UNL-Lunabotics/2026-tibble-bot/ros2/description/meshes/TLA.STL

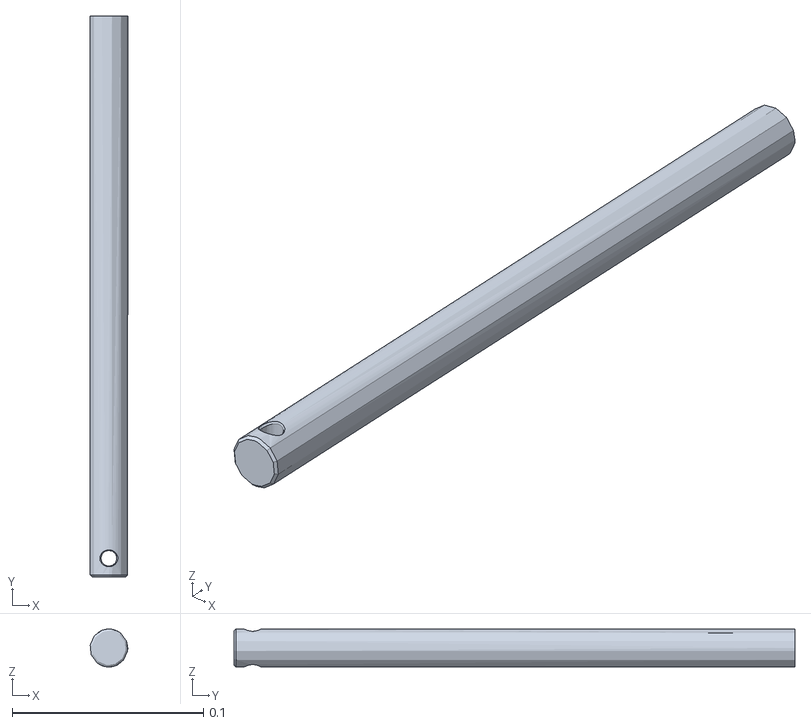
[picture p1: CAD file, 2026-03-10]
ros2/description/meshes/TLA.STL
0.0197 x 0.293 x 0.0199
