UNL-Lunabotics/2026-tibble-bot/ros2/description/meshes/TL_Wheel.STL

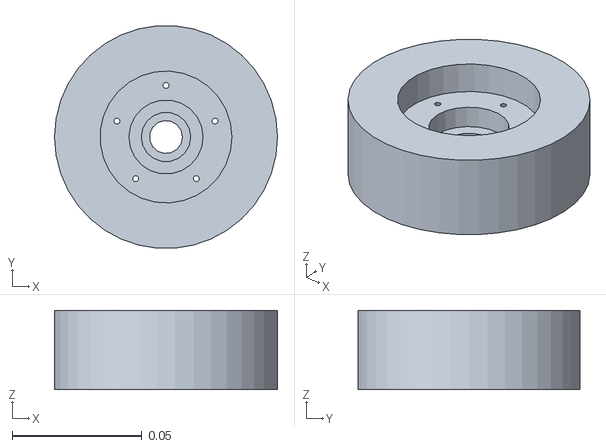
[picture p2: CAD file, 2026-03-10]
ros2/description/meshes/TL_Wheel.STL
0.0859 x 0.0856 x 0.0305
