UNL-Lunabotics/2026-tibble-bot/ros2/description/meshes/FR_Wheel.STL

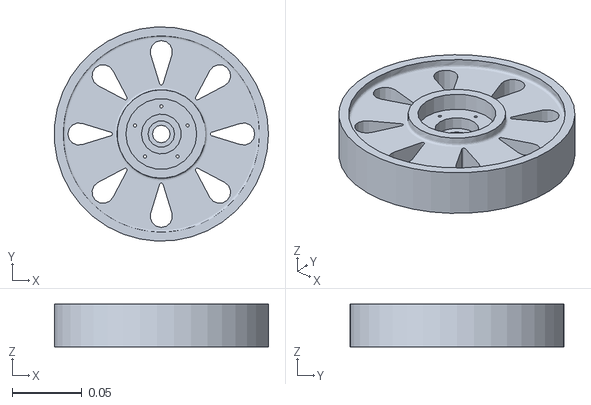
[picture p3: CAD file, 2026-03-10]
ros2/description/meshes/FR_Wheel.STL
0.153 x 0.154 x 0.0305
