UNL-Lunabotics/2026-tibble-bot/ros2/description/meshes/Excavation.STL

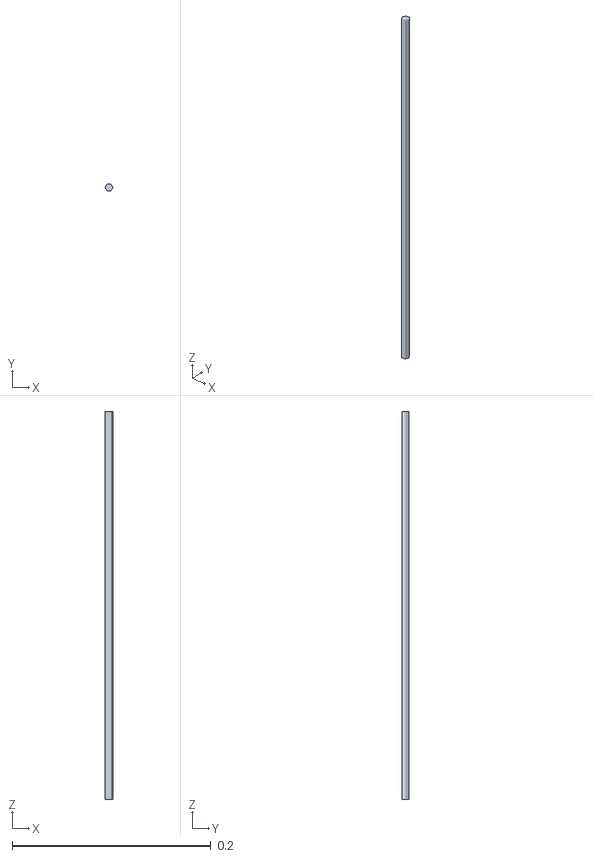
[picture p4: CAD file, 2026-03-10]
ros2/description/meshes/Excavation.STL
0.00808 x 0.007 x 0.39
