UNL-Lunabotics/2026-tibble-bot/ros2/description/meshes/Hopper_Door.STL

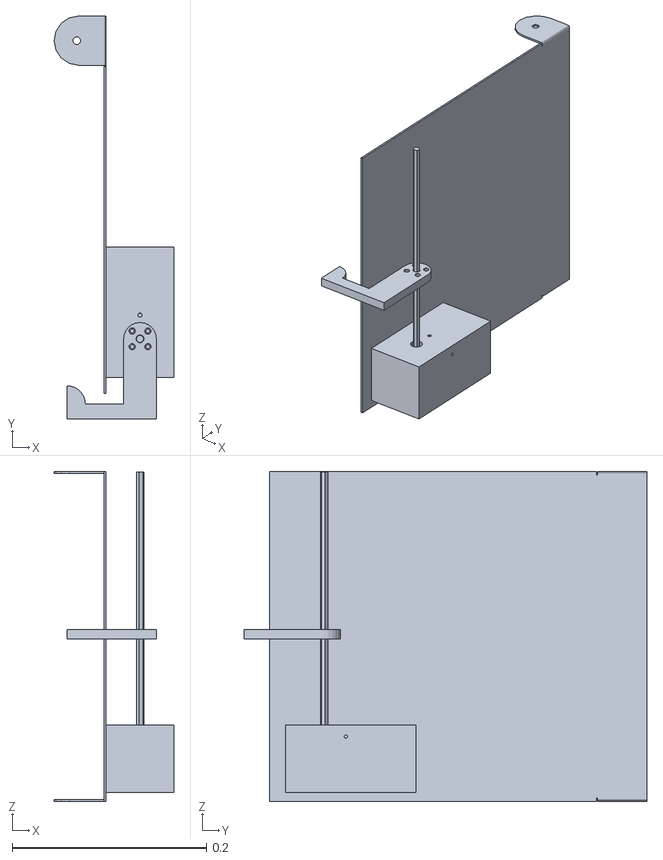
[picture p5: CAD file, 2026-03-10]
ros2/description/meshes/Hopper_Door.STL
0.123 x 0.415 x 0.34
