UNL-Lunabotics/2026-tibble-bot/ros2/description/meshes/Hopper.STL

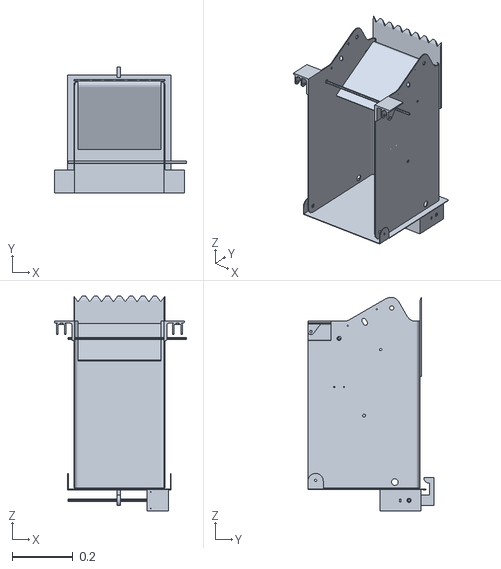
[picture p6: CAD file, 2026-03-10]
ros2/description/meshes/Hopper.STL
0.434 x 0.415 x 0.707
