UNL-Lunabotics/2026-tibble-bot/ros2/description/meshes/DL_Wheel.STL

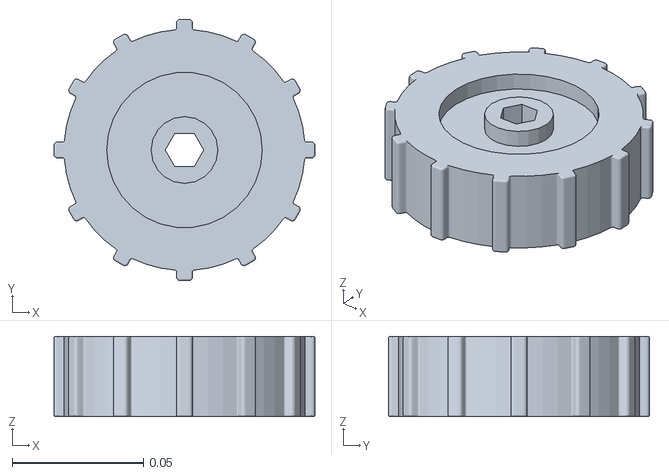
[picture p7: CAD file, 2026-03-10]
ros2/description/meshes/DL_Wheel.STL
0.0993 x 0.0993 x 0.0305
