UNL-Lunabotics/2026-tibble-bot/ros2/description/meshes/Hopper_Latch.STL

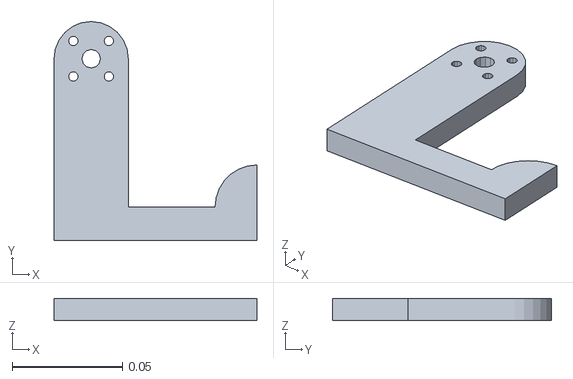
[picture p8: CAD file, 2026-03-10]
ros2/description/meshes/Hopper_Latch.STL
0.0922 x 0.0994 x 0.0102
