UNL-Lunabotics/2026-tibble-bot/ros2/description/meshes/BLA.STL

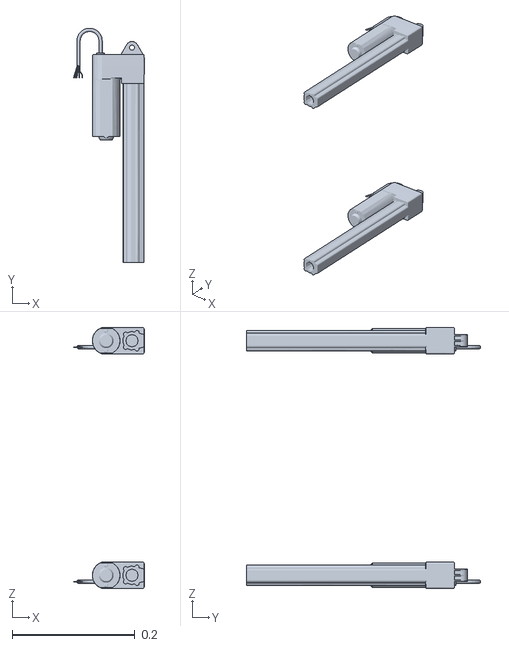
[picture p9: CAD file, 2026-03-07]
ros2/description/meshes/BLA.STL
0.115 x 0.382 x 0.425
