UNL-Lunabotics/2026-tibble-bot/ros2/description/meshes/base_link.STL

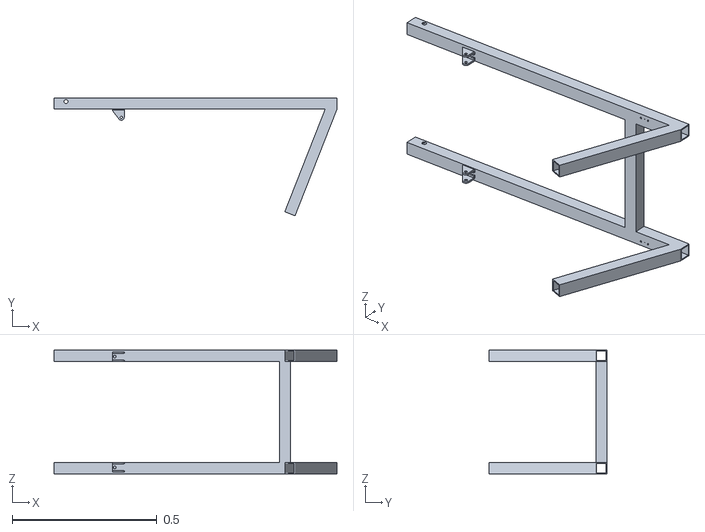
[picture p10: CAD file, 2026-03-07]
ros2/description/meshes/base_link.STL
0.976 x 0.406 x 0.426
