UNL-Lunabotics/2026-tibble-bot/(list of files, cad)

Other CAD files:
ros2/description/meshes/MR_Wheel.STL
ros2/description/meshes/TR_Wheel.STL
ros2/description/meshes/LA.STL
ros2/description/meshes/ML_Wheel.STL
ros2/description/meshes/BL_Wheel.STL
ros2/description/meshes/FL_Wheel.STL
ros2/description/meshes/DR_Wheel.STL
ros2/description/meshes/BR_Wheel.STL
