UNL-Lunabotics/2026-tibble-bot/ros2/control/src/tibble_controller.cpp

#include "control/tibble_controller.hpp"

#include <algorithm>
#include <optional>

#include <pluginlib/class_list_macros.hpp>
#include "hardware_interface/types/hardware_interface_type_values.hpp"

namespace tibble_controller
{
    controller_interface::InterfaceConfiguration TibbleController::command_interface_configuration() const
    {
        controller_interface::InterfaceConfiguration config;
        config.type = controller_interface::interface_configuration_type::INDIVIDUAL;
        config.names = { // order in here determines array index order
            left_wheel_name_ + "/velocity",
            right_wheel_name_ + "/velocity",
            linear_actuator_name_ + "/position",
            excavation_name_ + "/velocity",
            vibe_gpio_name_ + "/vibe_enabled",
            latch_gpio_name_ + "/hop_latched",
            linear_actuator_name_ + "/la_reset"
        };

        return config;
    }

    controller_interface::InterfaceConfiguration TibbleController::state_interface_configuration() const
    {
        controller_interface::InterfaceConfiguration config;
        config.type = controller_interface::interface_configuration_type::INDIVIDUAL;

        config.names = {
            left_wheel_name_ + "/velocity",
            left_wheel_name_ + "/position",
            right_wheel_name_ + "/velocity",
            right_wheel_name_ + "/position",
            linear_actuator_name_ + "/position"
        };

        return config;
    }

    controller_interface::CallbackReturn TibbleController::on_init()
    {
        try
        {
            // Receive params from tibble_controller.yaml
            auto_declare<double>("wheel_radius_m", 0.0);
            auto_declare<double>("wheel_separation_m", 0.0);
            auto_declare<double>("paddle_speed", 0.0);
            auto_declare<double>("manual_paddle_max_speed", 0.0);
            auto_declare<double>("manual_la_speed", 0.0);
        }
        catch(const std::exception& e)
        {
            RCLCPP_ERROR(get_node()->get_logger(), "on_init exception: %s", e.what());
            return controller_interface::CallbackReturn::ERROR;
        }
        return controller_interface::CallbackReturn::SUCCESS;
    }

    controller_interface::CallbackReturn TibbleController::on_configure(const rclcpp_lifecycle::State &)
    {
        // Set local variables to the node parameter values
        wheel_radius_ = get_node()->get_parameter("wheel_radius_m").as_double();
        wheel_separation_ = get_node()->get_parameter("wheel_separation_m").as_double();
        paddle_speed_ = get_node()->get_parameter("paddle_speed").as_double();
        manual_paddle_max_speed_ = get_node()->get_parameter("manual_paddle_max_speed").as_double();
        manual_la_speed_ = get_node()->get_parameter("manual_la_speed").as_double();

        // ROS subscriptions
        cmd_vel_sub_ = get_node()->create_subscription<geometry_msgs::msg::Twist>(
            "/cmd_vel", rclcpp::SystemDefaultsQoS(),
            [this](const geometry_msgs::msg::Twist::SharedPtr msg) {
                twist_cmd_buffer_.writeFromNonRT(*msg);
            });
        
        joy_sub_ = get_node()->create_subscription<sensor_msgs::msg::Joy>(
            "/joy", rclcpp::SystemDefaultsQoS(),
            [this](const sensor_msgs::msg::Joy::SharedPtr msg) {
                joy_cmd_buffer_.writeFromNonRT(*msg);
            });
        
        // ROS publishers
        odom_pub_ = get_node()->create_publisher<nav_msgs::msg::Odometry>("/odom", rclcpp::SystemDefaultsQoS());
        tf_broadcaster_ = std::make_shared<tf2_ros::TransformBroadcaster>(*get_node());

        // Create the service server for set state
        state_service_ = get_node()->create_service<interfaces::srv::SetTibbleState>(
            "~/set_state",
            std::bind(&TibbleController::set_state_callback, this, std::placeholders::_1, std::placeholders::_2)
        );

        RCLCPP_INFO(get_node()->get_logger(), "Configured TibbleController.");
        
        return controller_interface::CallbackReturn::SUCCESS;
    }

    controller_interface::CallbackReturn TibbleController::on_activate(const rclcpp_lifecycle::State &)
    {
        current_state_ = STATE_IDLE;
        manual_mode_ = false;

        twist_cmd_buffer_.reset();
        joy_cmd_buffer_.reset();

        // Odom reset
        odom_x_ = 0.0;
        odom_y_ = 0.0;
        odom_theta_ = 0.0;
        first_update_ = true;
        
        // Manual mode reset
        latch_state_ = true;
        vibe_state_ = false;
        prev_manual_toggle_b_ = false;
        prev_latch_toggle_b_ = false;
        prev_vibe_toggle_b_ = false;
        first_joy_update_ = true;
        prev_la_reset_b_ = false;

        odom_pub_->on_activate();

        if (command_interfaces_.empty() || state_interfaces_.empty()) {
            RCLCPP_ERROR(get_node()->get_logger(), "Missing controller interfaces.");
            return controller_interface::CallbackReturn::ERROR;
        }

        RCLCPP_INFO(get_node()->get_logger(), "Activated TibbleController.");
        return controller_interface::CallbackReturn::SUCCESS;
    }
   
    controller_interface::CallbackReturn TibbleController::on_deactivate(const rclcpp_lifecycle::State &)
    {
        current_state_ = STATE_IDLE;
        manual_mode_ = false;

        odom_pub_->on_deactivate();

        RCLCPP_INFO(get_node()->get_logger(), "Deactivated TibbleController.");
        return controller_interface::CallbackReturn::SUCCESS;
    }

    void TibbleController::set_state_callback(
        const std::shared_ptr<interfaces::srv::SetTibbleState::Request> request,
        std::shared_ptr<interfaces::srv::SetTibbleState::Response> response)
    {
        if (manual_mode_) {
            response->success = false;
            response->message = "Service rejected: Controller is currently in MANUAL mode.";
            return;
        }

        if (request->requested_state > STATE_DUMP) {
            response->success = false;
            response->message = "Invalid state requested.";
            return;
        }

        current_state_.store(request->requested_state);
        
        response->success = true;
        response->message = "State transitioned successfully.";
        
        RCLCPP_INFO(get_node()->get_logger(), "Service call received: Switched to state %d", request->requested_state);
    }

    controller_interface::return_type TibbleController::update(const rclcpp::Time & time, const rclcpp::Duration & period)
    {
        (void)time; // Silence unused param warning

        if (period.seconds() <= 0.0) {
            return controller_interface::return_type::OK;
        }

        // --- First, read inputs ---
        double current_left_pos = state_interfaces_[1].get_optional().value_or(0.0);
        double current_right_pos = state_interfaces_[3].get_optional().value_or(0.0);
        double current_la_pos = state_interfaces_[4].get_optional().value_or(0.0);

        // --- Second, odometry math ---
        if (first_update_) {
            last_left_wheel_pos_ = current_left_pos;
            last_right_wheel_pos_ = current_right_pos;
            manual_la_pos_ = current_la_pos; // Init manual position tracker
            first_update_ = false;
        }

        // Calculate how much the wheels moved in radians since last tick
        double delta_left = current_left_pos - last_left_wheel_pos_;
        double delta_right = current_right_pos - last_right_wheel_pos_;

        // Convert radians to linear distance (meters)
        double distance_left = delta_left * wheel_radius_;
        double distance_right = delta_right * wheel_radius_;

        // Calculate robot's translation and rotation
        double linear_distance = (distance_right + distance_left) / 2.0;
        double angular_distance = (distance_right - distance_left) / wheel_separation_;

        // Update global pose using Runge-Kutta 2nd order approximation
        odom_theta_ += angular_distance;
        odom_x_ += linear_distance * std::cos(odom_theta_ - angular_distance / 2.0);
        odom_y_ += linear_distance * std::sin(odom_theta_ - angular_distance / 2.0);

        // Save current positions for the next loop
        last_left_wheel_pos_ = current_left_pos;
        last_right_wheel_pos_ = current_right_pos;

        // Publish Odometry & TF (Helper struct for quaternion math)
        double half_yaw = odom_theta_ * 0.5;
        double q_z = std::sin(half_yaw);
        double q_w = std::cos(half_yaw);

        if (odom_pub_->get_subscription_count() > 0) {
            nav_msgs::msg::Odometry odom_msg;
            odom_msg.header.stamp = get_node()->get_clock()->now();
            odom_msg.header.frame_id = "odom";
            odom_msg.child_frame_id = "base_link";
            odom_msg.pose.pose.position.x = odom_x_;
            odom_msg.pose.pose.position.y = odom_y_;
            odom_msg.pose.pose.orientation.z = q_z;
            odom_msg.pose.pose.orientation.w = q_w;
            odom_msg.twist.twist.linear.x = linear_distance / period.seconds();
            odom_msg.twist.twist.angular.z = angular_distance / period.seconds();
            odom_pub_->publish(odom_msg);
        }

        geometry_msgs::msg::TransformStamped tf_msg;
        tf_msg.header.stamp = get_node()->get_clock()->now();
        tf_msg.header.frame_id = "odom";
        tf_msg.child_frame_id = "base_link";
        tf_msg.transform.translation.x = odom_x_;
        tf_msg.transform.translation.y = odom_y_;
        tf_msg.transform.rotation.z = q_z;
        tf_msg.transform.rotation.w = q_w;
        tf_broadcaster_->sendTransform(tf_msg);

        // --- Third, read commands and process mode toggle ---
        auto twist_msg = twist_cmd_buffer_.readFromRT();
        auto joy_msg = joy_cmd_buffer_.readFromRT();

        if (joy_msg && joy_msg->buttons.size() > (size_t)std::max({MANUAL_TOGGLE_B, MANUAL_VIBE_TOGGLE_B})) {
            
            // Check for mode toggle edge detection
            if (first_joy_update_) {
                prev_manual_toggle_b_ = (joy_msg->buttons[MANUAL_TOGGLE_B] == 1);
                prev_latch_toggle_b_ = (joy_msg->buttons[MANUAL_LATCH_TOGGLE_B] == 1);
                prev_vibe_toggle_b_ = (joy_msg->buttons[MANUAL_VIBE_TOGGLE_B] == 1);
                prev_la_reset_b_ = (joy_msg->buttons[MANUAL_LA_RESET_B] == 1);
                first_joy_update_ = false;
            } else {
                bool current_manual_toggle = (joy_msg->buttons[MANUAL_TOGGLE_B] == 1);
                if (current_manual_toggle && !prev_manual_toggle_b_) {
                    manual_mode_ = !manual_mode_;
                    
                    if (!manual_mode_) {
                        current_state_ = STATE_IDLE;
                    }
                }
                prev_manual_toggle_b_ = current_manual_toggle;
            }
        }

        // Initialize safe output defaults
        double target_v = 0.0;
        double target_w = 0.0;
        double cmd_left_wheel = 0.0;
        double cmd_right_wheel = 0.0;
        double cmd_la_pos = 0.0;
        double cmd_excav_vel = 0.0;
        double cmd_vibe = 0.0;     // 0.0 = off, 1.0 = on
        double cmd_latch = latch_state_ ? 1.0 : 0.0;
        double cmd_la_reset = 0.0;

        // Read drivetrain twist
        if (twist_msg) {
            target_v = twist_msg->linear.x;
            target_w = twist_msg->angular.z;
        }

        // --- Fourth, Mode Execution Logic ---
        if (manual_mode_) {
            // ==========================================
            // MANUAL MODE LOGIC
            // ==========================================
            if (joy_msg) {
                bool extending = (joy_msg->buttons[MANUAL_LA_EXTEND_B] == 1);
                bool retracting = (joy_msg->buttons[MANUAL_LA_RETRACT_B] == 1);

                // Linear Actuator (Pseudo-Velocity)
                if (extending) {
                    cmd_la_pos = 1.0;
                } else if (retracting) {
                    cmd_la_pos = -1.0;
                } else {
                    cmd_la_pos = current_la_pos;
                }
  
                // Excavation
                if (joy_msg->axes.size() > (size_t)MANUAL_EXCAV_AXIS) {
                    double excav_axis = joy_msg->axes[MANUAL_EXCAV_AXIS];
                    // Map 1.0 -> 0 and -1.0 to 1.0 * max speed
                    // When not pressed at all, it is at 1.0, and when fully pressed it is -1.0
                    cmd_excav_vel = (-(excav_axis - 1.0) / 2.0) * manual_paddle_max_speed_;
                }

                // Latch Toggle
                bool current_latch_btn = (joy_msg->buttons[MANUAL_LATCH_TOGGLE_B] == 1);
                if (current_latch_btn && !prev_latch_toggle_b_) {
                    latch_state_ = !latch_state_;
                }
                prev_latch_toggle_b_ = current_latch_btn;
                cmd_latch = latch_state_ ? 1.0 : 0.0;

                // Vibe Toggle
                bool current_vibe_btn = (joy_msg->buttons[MANUAL_VIBE_TOGGLE_B] == 1);
                if (current_vibe_btn && !prev_vibe_toggle_b_) {
                    vibe_state_ = !vibe_state_;
                }
                prev_vibe_toggle_b_ = current_vibe_btn;
                cmd_vibe = vibe_state_ ? 1.0 : 0.0;

                bool current_la_reset_btn = (joy_msg->buttons[MANUAL_LA_RESET_B] == 1);
                if (current_la_reset_btn && !prev_la_reset_b_) {
                    cmd_la_reset = 1.0;
                    RCLCPP_WARN(get_node()->get_logger(), "MANUAL OVERRIDE: Triggering Linear Actuator Encoder Reset!");
                }
                prev_la_reset_b_ = current_la_reset_btn;
            }

            // Differential Drive Math (No speed multipliers in manual)
            cmd_left_wheel = (target_v - target_w * wheel_separation_ / 2.0) / wheel_radius_;
            cmd_right_wheel = (target_v + target_w * wheel_separation_ / 2.0) / wheel_radius_;

        } else {
            // ==========================================
            // STATE MACHINE LOGIC
            // ==========================================
            uint8_t local_state = current_state_.load();

            // Timer management for sequential steps
            if (local_state != previous_state_) {
                state_timer_ = 0.0;
                previous_state_ = local_state;
            } else {
                state_timer_ += period.seconds();
            }

            double speed_multiplier = 1.0;

            switch (local_state) {
                case STATE_IDLE:
                    // Safe defaults are already set above
                    break;

                case STATE_TRAVEL:
                    // Drivetrain runs, default positions hold
                    break;

                case STATE_EXCAVATE:
                    target_v = 0.2;
                    target_w = 0.0;
                    speed_multiplier = 1.0;

                    cmd_vibe = 1.0;
                    
                    cmd_la_pos = -1.0; // retract LA's forever
                    
                    cmd_excav_vel = paddle_speed_;
                    break;

                case STATE_DUMP:
                    speed_multiplier = 0.3; // Slow down drivetrain
                    
                    latch_state_ = false;
                    cmd_latch = 0.0; // Unlatch immediately

                    if (state_timer_ > DUMP_LA_DELAY && state_timer_ < (DUMP_LA_DELAY + EXCAVATE_EXTEND_TIME)) {
                        cmd_la_pos = 1.0; // Extend LA
                    } else if (state_timer_ >= (DUMP_LA_DELAY + EXCAVATE_EXTEND_TIME)) {
                        cmd_la_pos = 0.0; // Stop LA
                    }

                    if (state_timer_ > DUMP_VIBE_DELAY) {
                        cmd_vibe = 1.0;
                    }
                    break;
            }

            // Differential Drive Math (applied for TRAVEL, EXCAVATE, and DUMP)
            if (local_state != STATE_IDLE) {
                target_v *= speed_multiplier;
                target_w *= speed_multiplier;

                cmd_left_wheel = (target_v - target_w * wheel_separation_ / 2.0) / wheel_radius_;
                cmd_right_wheel = (target_v + target_w * wheel_separation_ / 2.0) / wheel_radius_;
            }
        }

        // no matter what, clamp to LA max (no min enforced)
        // cmd_la_pos = std::min(cmd_la_pos, LA_DUMP_POS);

        // --- Fifth, write commands ---
        
        // Order is declaration order in command_interface_configuration()
        (void)command_interfaces_[0].set_value(cmd_left_wheel);
        (void)command_interfaces_[1].set_value(cmd_right_wheel);
        (void)command_interfaces_[2].set_value(cmd_la_pos);
        (void)command_interfaces_[3].set_value(cmd_excav_vel);
        (void)command_interfaces_[4].set_value(cmd_vibe);
        (void)command_interfaces_[5].set_value(cmd_latch);
        (void)command_interfaces_[6].set_value(cmd_la_reset);

        RCLCPP_INFO_THROTTLE(get_node()->get_logger(), *get_node()->get_clock(), 3000,
            "MODE: %s | LA Cmd: %.4f | Vibe: %.0f | Latch: %.0f | Paddle: %.2f",
            manual_mode_ ? "MANUAL" : "STATE MACHINE",
            cmd_la_pos, cmd_vibe, cmd_latch, cmd_excav_vel);

        return controller_interface::return_type::OK;
    }

} // namespace tibble_controller


PLUGINLIB_EXPORT_CLASS(tibble_controller::TibbleController,
                       controller_interface::ControllerInterface)
