UNL-Lunabotics/2026-tibble-bot/(commit log)

2026-03-06 set all the ros2 packages up and ported over docker and teensy firmware from terrence 3
2026-03-07 control starting stuff from terrence
    [controllers.yaml]
2026-03-07 updated readme with state machine and motor info
2026-03-07 added basic urdf in and got a view urdf launcher working
    [Excavation_Link.STL, HopperDoor_Link.STL, Hopper_Link.STL, Hopperlatch_Link.STL, LAExtend_Link.STL, LA_Link.STL, LKraken_Link.STL, RKraken_Link.STL]
2026-03-07 added urdf migration notes to readme
2026-03-08 rewrote the teensy firmware to handle tibbs architecture
2026-03-10 added in tibbs urdf and meshes
    [BLA.STL, BL_Wheel.STL, BR_Wheel.STL, DL_Wheel.STL, DR_Wheel.STL, Excavation.STL, Excavation_Link.STL, FL_Wheel.STL]
2026-03-10 renamed chassis stl. transforms to base link complaining
    [tibble.urdf.xacro]
2026-03-12 urdf of tibbs renders in rviz properly
    [tibble.urdf.xacro]
2026-03-21 fixed the joint issues
    [tibble.urdf.xacro]
2026-03-21 split into proper urdf structure
    [gazebo.xacro, ros2_control.xacro, sensors.xacro, tibble.urdf.xacro, tibble_core.xacro]
2026-03-21 added missing name for robot
    [tibble.urdf.xacro]
2026-03-21 renamed controllers to tiblle_controller for clarity
    [tibble_controller.yaml]
2026-03-21 forgot to commit delete old controllers.yaml
    [controllers.yaml]
2026-03-21 changed robot name in urdf to uppercase Tibble
    [tibble.urdf.xacro]
2026-03-21 gave all the revolute and prismatic joints proper ranges so they show up (not mathematically correct)
    [tibble_core.xacro]
2026-03-21 defined joints and interfaces for ros2 control (not sim)
    [ros2_control.xacro]
2026-03-21 initial prototype controller (just writing, no reading encoders yet)
    [ros2_control.xacro]
2026-03-21 added odometry logic and physical position checking in
    [ros2_control.xacro]
2026-03-21 theoretically the hardware component is done, arduino comms revised, need to make can comms
    [ros2_control.xacro]
2026-03-21 teensy firmware updated
2026-03-21 added in slop can comms file that will need to be changed once we get that working
    [can_comms.hpp, tibble_hwc.cpp, tibble_hwc.hpp]
2026-03-25 yaml updated
    [tibble_controller.yaml]
2026-03-25 set up the individual arduino test scripts
2026-03-25 replaced controller placeholders with real values
    [tibble_controller.yaml]
2026-03-25 replaced placeholder REST and DUMP pos for LAs with real values
    [tibble_controller.hpp]
2026-03-27 updated teensy files
2026-03-27 can_comms and cmake edited to include correct phoenix6 stuff
    [can_comms.hpp]
2026-03-27 added in correct button schema for ellas wireless 8bit controler
    [tibble_controller.hpp]
2026-03-27 moved test files and fixed controller file path
    [excav_test.cpp]
2026-03-27 fixed name of param
    [ros2_control.xacro]
2026-03-27 fixed some interface mismatches between hwc and urdf
    [ros2_control.xacro]
2026-03-27 fixed excav interfaces in controller
    [tibble_controller.cpp]
2026-03-27 fixed transform and calc mismatches in the controller
    [tibble_controller.cpp]
2026-03-28 updated to use wired 3d pro controller not bluetooth
2026-03-28 updated a number of small bugs here and there
    [ros2_control.xacro, tibble_controller.yaml]
2026-03-28 temporarily commented out the encoder readings just to see if thats the bottleneck
2026-03-28 switched to global joy and vel topics
2026-03-28 updated teensy firmware
2026-03-28 fixed using undeclared var in firmware
    [main.cpp]
2026-03-28 added received commands indicator to teensy leds
2026-03-28 removed conditional breaking encoder feedback
2026-03-28 removed all la encoder reset logic
    [ros2_control.xacro]
2026-03-28 removed read encoder values reference to excav encoders
2026-03-28 Revert "removed all la encoder reset logic"
    This reverts commit d4a57ae18a7980f2c8775c0c08da8bf0d5364fba.
    [ros2_control.xacro]
2026-03-28 temp absurdly high tolerance for la out of sync
    [tibble_hwc.hpp]
2026-03-28 im so fucking tired man
2026-03-28 im still so tired
2026-04-04 added joystick support for teensy theoretically
2026-04-04 fixed odom to use lifecycle and be global
    [tibble_controller.cpp, tibble_controller.hpp]
2026-04-08 updated arduino test files
2026-04-09 fixed roboclaw issue AGAIN this is so annoying
    [manual_joystick.cpp]
2026-04-09 added led signal on teensy code
2026-04-09 added excac test back in but commented out drivetrain and LA movement
2026-04-09 other changes i forgot to stage :)
2026-04-09 made la encoder specific teensy test code
2026-04-09 made the la test code not terrible :)
2026-04-11 joystick control with simple python file + teensy script is working fully (on ellas computer with ellas 8bitdo controller)
2026-04-17 reworked how LA encoders work
    [main.cpp, manual_joystick.cpp, tibble_hwc.cpp]
2026-04-18 added in new urdf but it is identical to the old one
    [tibble_core_old.xacro]
2026-04-18 fixed issues with joystick yaml still being for 8bitdo and added stuff for manual mode
    [tibble_controller.yaml]
2026-04-18 added manual switch println
2026-04-18 added std:: before println
2026-04-18 added diagnostic debug print
2026-04-18 fixed it so the arduino comms is only looking for 2 encoders not 3 which was impossible
    [arduino_comms.hpp]
2026-04-18 allowing LA encoders to go negative
2026-04-18 swapped excav and vibe instructions (they were reversed on accident)
    [main.cpp]
2026-04-18 split teleop launch files into wireless mode
2026-04-18 handling the no button pressed state for LA manual mode
2026-04-18 fixed the logic oops
    [tibble_controller.cpp]
2026-04-18 added fix for excav spinning wrong way in hwc
    [main.cpp, tibble_hwc.cpp]
2026-04-18 switched hop servo from pin 7 to 9
2026-04-18 added velocity clamp to hopefully move the drivetrain
2026-04-18 added duty cycle ignoring pid
2026-04-18 making drivetrain and excavation faster
    [tibble_controller.yaml]
2026-04-23 initial prototype for cameras in wireless launch files
2026-04-24 i forgot to comment out the camera_rear object in launch description
2026-04-25 reversed excav direction and increased joystick
    [tibble_hwc.cpp]
2026-04-25 swopped hop servo values and it works now
2026-04-26 deleted obsolete teensy scripts
2026-04-26 renamed teensy_firmware to microcontroller_firmware
2026-04-26 added tibble bringup script that theoretically sets up onboard and groundstation console fully
2026-04-26 theoretically fixed the LA velocity vs simple on/off control problem
    [tibble_controller.cpp]
2026-04-26 added full stop commands during on_activate to prevent previous cmds from echoing to new runs
    [tibble_controller.cpp, tibble_controller.hpp, tibble_hwc.cpp]
2026-04-27 switched to using zenoh for network managing
2026-05-01 updated teensy code for new addresses
2026-05-02 fixed LA error tolerance to not be infinity
    [tibble_hwc.hpp]
2026-05-02 added min/max clamp to LAs for manual and state machine mode
2026-05-02 added manual LA encoder reset button into manual mode
2026-05-02 fixed var typo preventing compile
    [tibble_controller.hpp]
2026-05-02 added LA encoder debug message to hwc
2026-05-02 fixed compile error with dedicated steady clock obj
    [tibble_hwc.cpp]
2026-05-02 clamp to 0.0 instead of excav pos
2026-05-02 changed to default to EXCAV state and have no la min
2026-05-02 changed the print commands to 3s
2026-05-02 removed v1 and v2 safety check for teensy firmware to force enc values
2026-05-02 removed compile error with .load
    [tibble_controller.cpp]
2026-05-02 swapped tracking la enc to la 2
    [tibble_hwc.cpp]
2026-05-02 updated ticks per meter and added debug print
2026-05-05 swapped file// uri to package// so it works in foxglove
    [tibble_core.xacro]
2026-05-05 moved foxglove bridge from groundstation to onboard launch
2026-05-05 just kidding, added the foxglove bridge back to groundstation
2026-05-06 added in rear camera with correct serial number
2026-05-07 added an idle emergency stop command for teensy
2026-05-07 hotfix timer based LA controls
2026-05-10 added limit switch logic to teensy code
2026-05-10 fixed the internal wifi card not getting disabled when using antenna launch
2026-05-11 removed la enc print
2026-05-13 removed antenna setup from bringup script
2026-05-14 theoretically fixed the hopper latch moving when it shouldnt
    [tibble_controller.cpp]
2026-05-16 added a spam filter for the can sync errors
2026-05-16 corrected wired joystick indexes
    [tibble_controller.hpp]
2026-05-16 removed excav axis clamp from -1.0 to 1.0 and 0.0 to max speed
2026-05-16 for real fixed the excav axis remapping :)
    [tibble_controller.cpp]
2026-05-17 swapped excav and dump buttons
    [state_manager_node.cpp]
2026-05-17 removed excav from teensy code
2026-05-19 commented out limit switch
2026-05-26 implemented mock hardware component
    [ros2_control.xacro, tibble.urdf.xacro]
